liuyuf78fk/Saturn-Controller-To-USB/README.md

# Saturn-Controller-To-USB

This is a project to change Saturn handle controller into USB interface,
which can be used to connect PC.

Cut off the joint of Saturn handle and weld it to the corresponding pad of PCB.
After burning the program, it can be used.

Demo video: 
https://youtu.be/lXBSZtI4mig
