liuyuf78fk/Saturn-Controller-To-USB/hardware/Demo picture/5.png

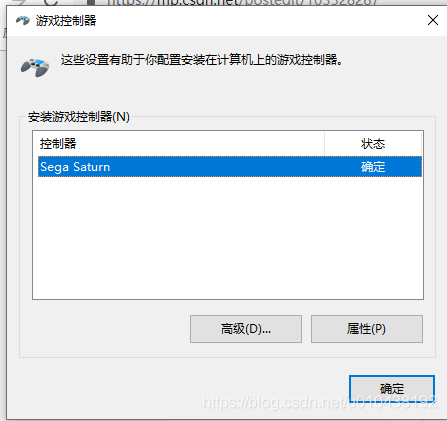
hardware/Demo picture/5.png
