liuyuf78fk/Saturn-Controller-To-USB/hardware/Demo picture/6.png

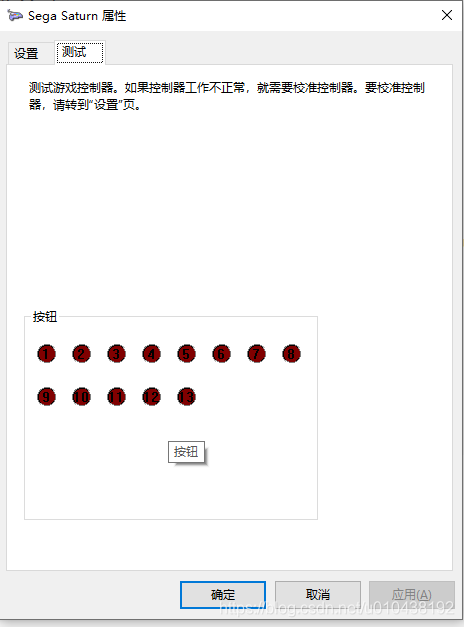
hardware/Demo picture/6.png
