liuyuf78fk/Saturn-Controller-To-USB/hardware/schematic diagram/BOM_sega saturn controller to usb_2021-06-13.csv

ID | Name | Designator | Footprint | Quantity | Manufacturer Part | Manufacturer | Supplier | Supplier Part | Price
1 | 100nF | C1,C3,C5,C7,C8,C9,C10,C11,C12 | C0805 | 9 | CC0603JRX7R8BB104 | YAGEO | LCSC | C327087 | 0.0589
2 | 10uF | C2,C4 | C0805 | 2 | C1608X5R1E106MT000E | TDK | LCSC | C76614 | 0.2706
3 | 20pF | C6,C13 | C0805 | 2 | CC0603JRX7R8BB104 | YAGEO | LCSC | C327087 | 0.0589
4 | HEADER-MALE-2.54_1X4 | H1 | HDR-TH_4P-P2.54-V | 1 | Header2.54mm 1*3P | BOOMELE | LCSC | C49257 | 0.0946
5 | HEADER-FEMALE-2.54_1X9 | P1 | 9P_2.54MM | 1 | Header-Female-2.54_1x10 | LCSC | LCSC | undefined
6 | 4.7K | R1 | R0805 | 1 | RMC06034.7k5%N | Tyohm | LCSC | C269694 | 0.0143
7 | 10K | R2 | R0805 | 1 | MR06X105JTL | Huaxin S&T | LCSC | C327832 | 0.0099
8 | 1M | R3 | R0805 | 1 | MR06X105JTL | Huaxin S&T | LCSC | C327832 | 0.0099
9 | STM32F103C8T6 | U1 | QFP-48_LSA9.20-LSB9.20-PITCH0.50-TL | 1 | STM32F103C8T6 | ST | LCSC | C8734 | 106.21
10 | XC6206P332MR_C347376 | U2 | SOT-23-3_L3.0-W1.7-P0.95-LS2.9-BR | 1 | XC6206P332MR | Youtai Semiconductor Co., Ltd. | LCSC | C347376 | 0.1405
11 | U-G-04DD-W-01 | USB1 | U-G-04WD-W-01 | 1 | U-G-04DD-W-01 | HRO | LCSC | C98125 | 0.4928
12 | 8MHz | X1 | HC-49US_L11.5-W4.5-P4.88 | 1 | XIHCELNANF-8MHZ | TAITIEN Elec | LCSC | C295088 | 0.6463
