liuyuf78fk/Saturn-Controller-To-USB/hardware/pcb/PCB_pcb_2021-06-13.pdf

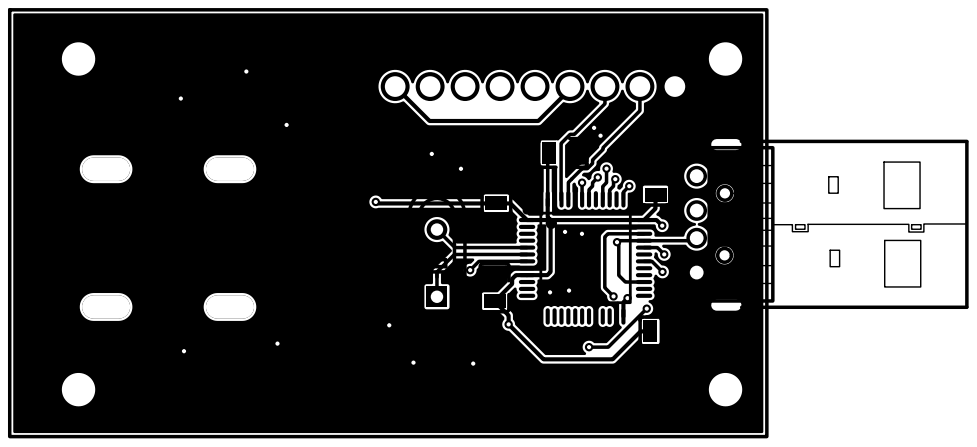
[picture p3: page 1]
