liuyuf78fk/Saturn-Controller-To-USB/hardware/schematic diagram/Schematic_sega saturn controller to usb_2021-06-13.pdf

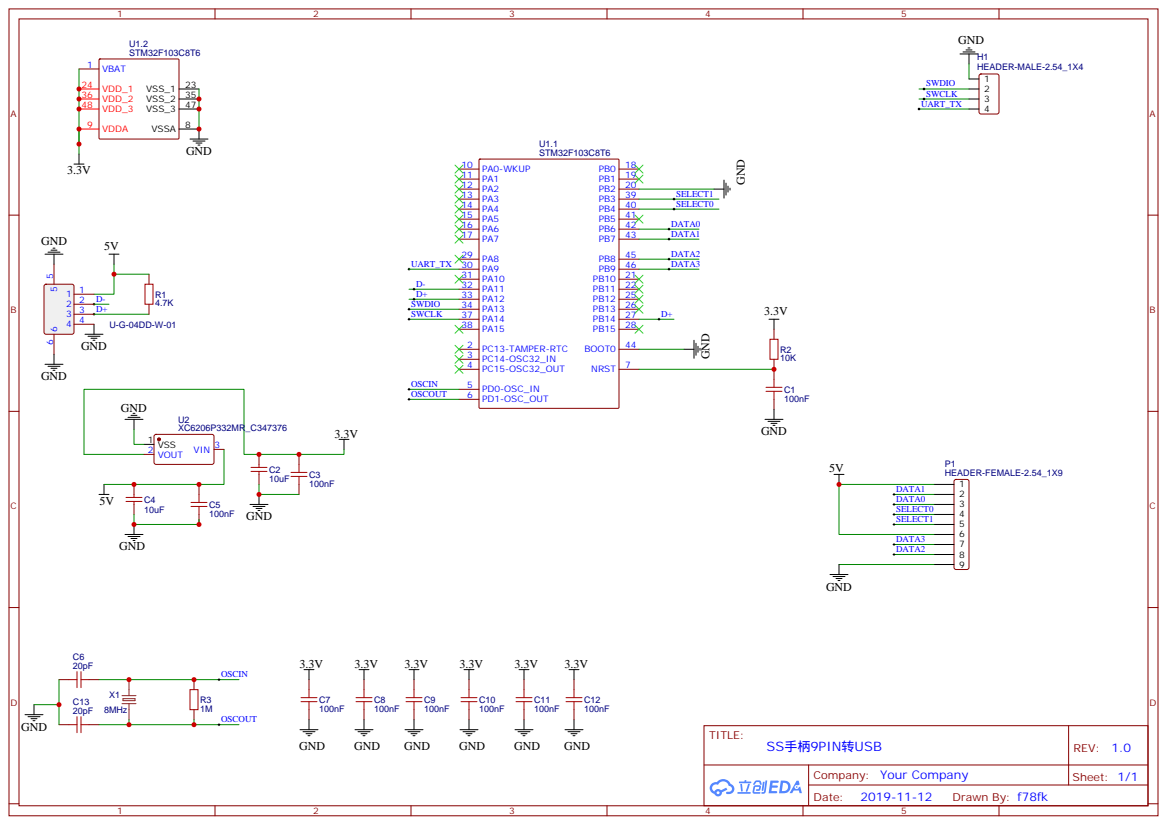
[picture p4: page 1]
