liuyuf78fk/Saturn-Controller-To-USB/(list of files, drawings)

Other design files:
hardware/pcb/PCB_pcb_2021-06-13.json
hardware/schematic diagram/SCH_sega saturn controller to usb_2021-06-13.json
