liuyuf78fk/Saturn-Controller-To-USB/software/F103/Inc/main.h

#define S0_Pin GPIO_PIN_4
#define S1_Pin GPIO_PIN_3
#define D0_Pin GPIO_PIN_6
#define D1_Pin GPIO_PIN_7
#define D2_Pin GPIO_PIN_8
#define D3_Pin GPIO_PIN_9
