liuyuf78fk/Saturn-Controller-To-USB/(notices)

Notices in the files:
software/F103/Inc/main.h:
© Copyright (c) 2019 STMicroelectronics.
All rights reserved.
This software component is licensed by ST under Ultimate Liberty license
(C) COPYRIGHT STMicroelectronics *****END OF FILE
